shuki25/7-segment-display-controller/7-segment-display-controller.png

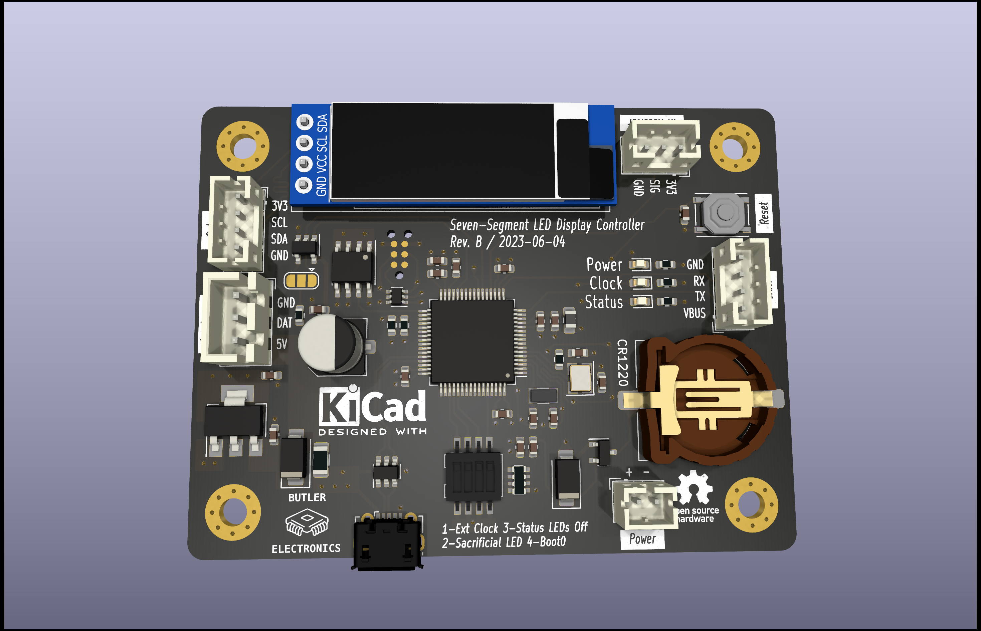
7-segment-display-controller.png
