shuki25/7-segment-display-controller/pdf/7-segment-display-controller__Assembly.pdf

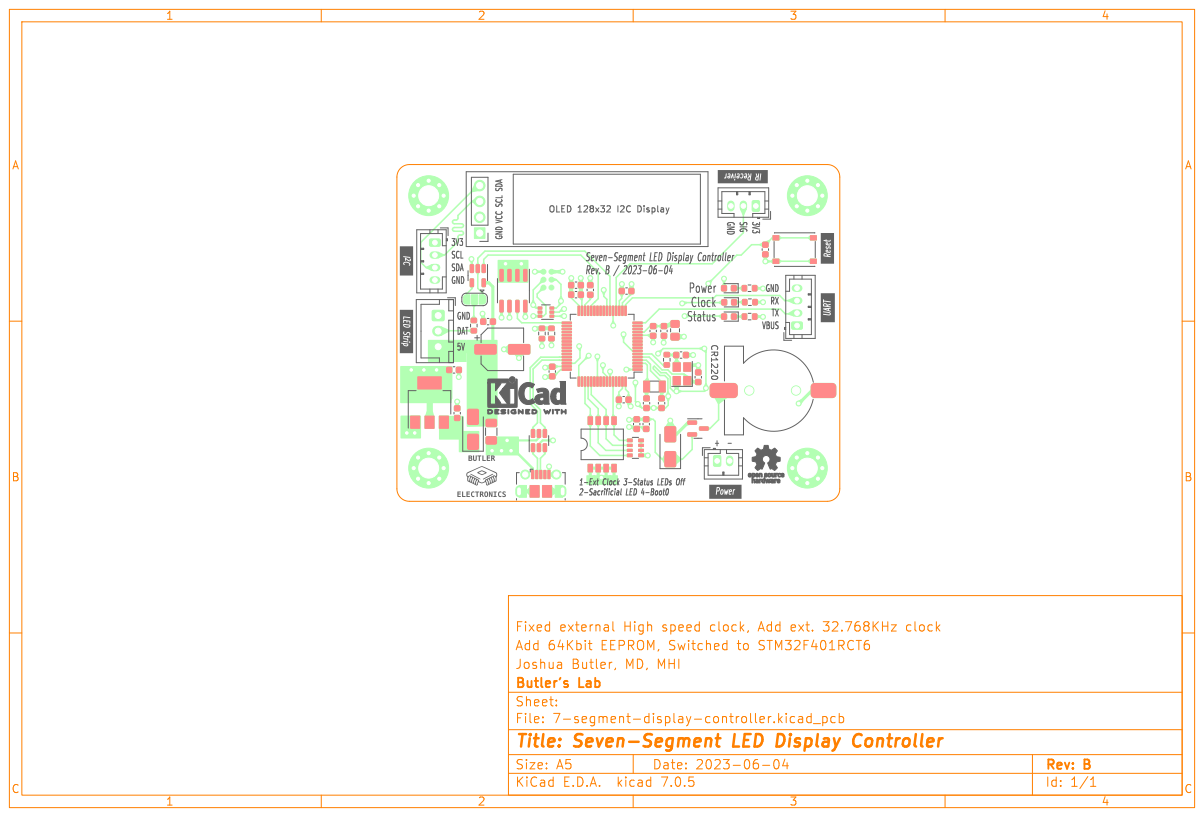
[picture p2: page 1]
SDA; Status; Seven-Segment LED Display Controller Rev. B / 2023-06-04; SIG 3V3; GND; GND CR1220; TX DAT GND; - 1-Ext Clock 3-Status LEDs Off 2-Sacrificial; LED 4-Boot0 SCL; Clock SDA GND; OLED 128x32 I2C Display SCL VCC 1; BC Date: 2023-06-04 KiCad; kicad; 7.0.5 Size: A5; Rev:; Id: 1/1 Title: Seven-Segment; LED Display Controller File: 7-segment-display-controller.kicad_pcb Sheet: Butler's; Lab; Joshua Butler,; MHI Add; 64Kbit EEPROM, Switched; to STM32F401RCT6 Fixed; external; High speed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

VBUS Power GND

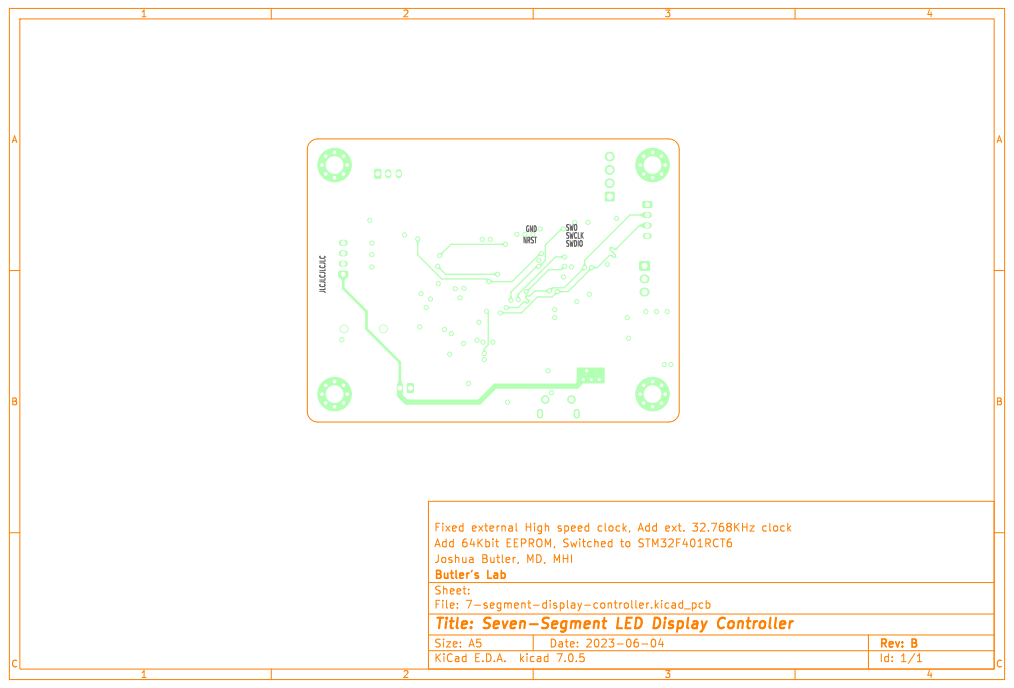
[picture p3: page 2]
BC Date: 2023-06-04 KiCad; kicad; 7.0.5 Size: A5; Rev:; Id: 1/1 Title: Seven-Segment; LED Display Controller File: 7-segment-display-controller.kicad_pcb Sheet: Butler's; Lab; Joshua Butler,; MHI Add; 64Kbit EEPROM, Switched; to STM32F401RCT6 Fixed; external; High speed; clock,; Add; ext. 32.768KHz; clock
