shuki25/7-segment-display-controller/pdf/7-segment-display-controller.pdf

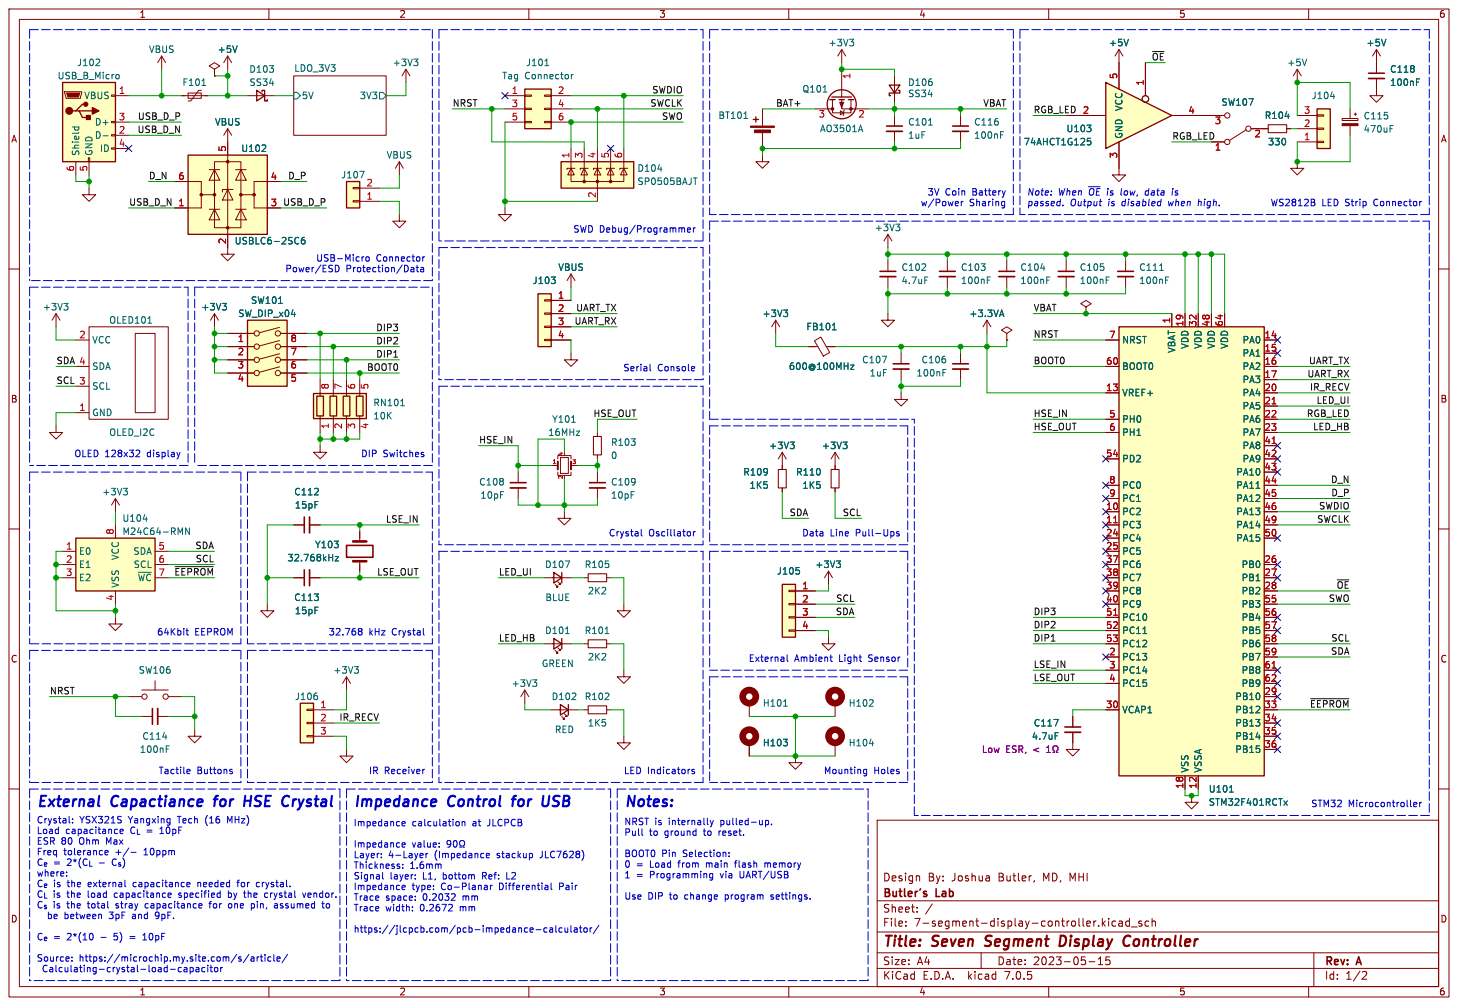
[picture p4: page 1]

1 PC2 10 PC3 11 VSSA 12 VREF+ 13 PA0 14 PA1 15 PA2 16 PA3 17 VSS 18 VDD 19 PC13 2 PA4 20 PA5 21 PA6 22 PA7 23 PC4 24 PC5 25 PB0 26 PB1 27 PB2 28 PB10 29 PC14 3 VCAP1 30 VDD 32 PB12 33 PB13 34 PB14 35 PB15 36 PC6 37 PC7 38 PC8 39 PC15 4 PC9 40 PA8 41 PA9 42 PA10 43 PA11 44 PA12 45 PA13 46 VDD 48 PA14 49 PH0 5 PA15 50 PC10 51 PC11 52 PC12 53 PD2 54 PB3 55 PB4 56 PB5 57 PB6 58 PB7 59 PH1 6 BOOT0 60 PB8 61 PB9 62 VDD 64 NRST 7 PC0 8 PC1 9 U101 STM32F401RCTx

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

4 SDA 5 SCL 6 ~{WC}7 VCC

Signal layer: L1, bottom Ref: L2

C_{e}= 2*(10 - 5) = 10pF Source: https://microchip.my.site.com/s/article/

https://jlcpcb.com/pcb-impedance-calculator/

Calculating-crystal-load-capacitor

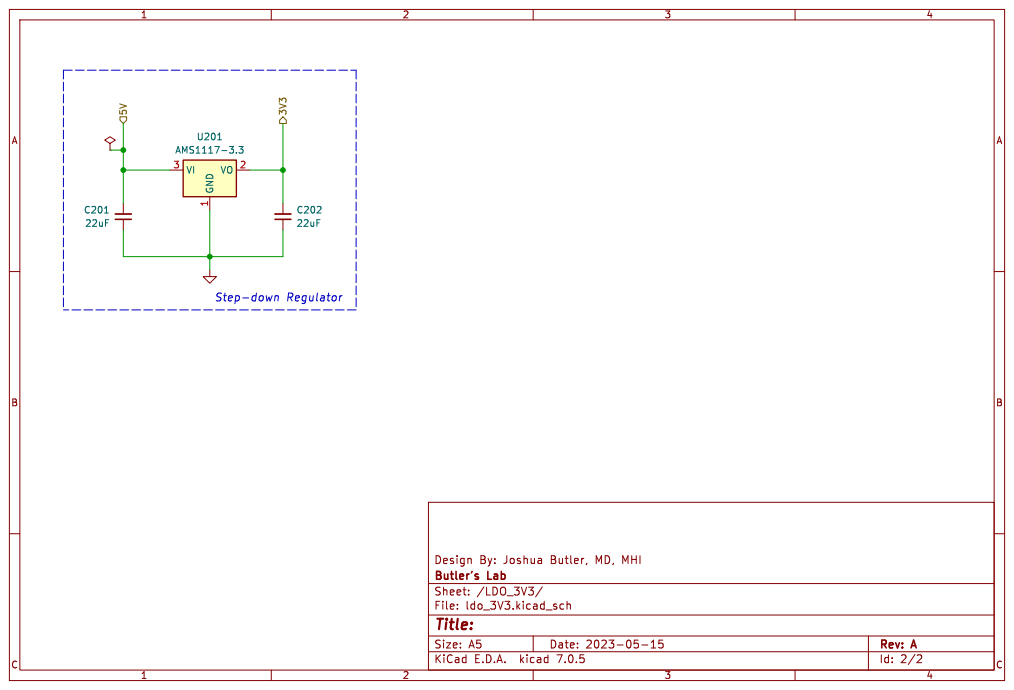
[picture p5: page 2]
