shuki25/7-segment-display-controller/7-segment-display-controller.kicad_pcb

## KiCad design 7-segment-display-controller.kicad_pcb (2023-06-27)

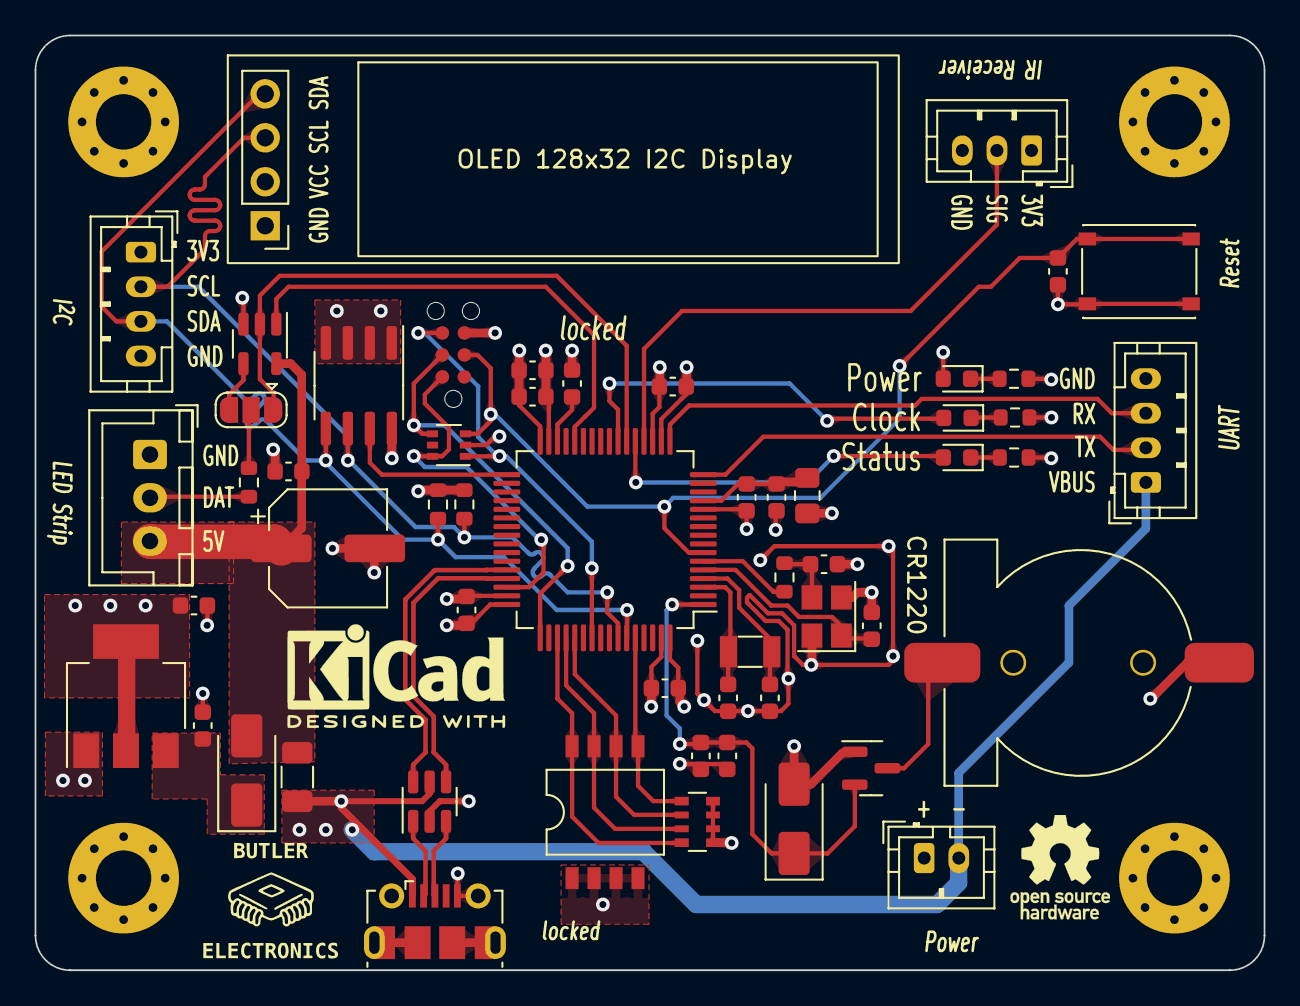
[picture p6: board 7-segment-display-controller.kicad_pcb from above]

Board: 4 copper layers, 71.0 x 54.0 mm, 59 parts (0 on the bottom side), 42 nets.

Parts:
BT101: Battery_Cell; BatteryHolder_CR1220
C101, C107: 1uF; C_0603_1608Metric
C102, C117: 4.7uF; C_0603_1608Metric
C103, C104, C105, C106, C111, C114, C116, C118: 100nF; C_0603_1608Metric
C108, C109: 10pF; C_0603_1608Metric
C112, C113: 15pF; C_0603_1608Metric
C115: 470uF; CP_Elec_6.3x7.7
C201, C202: 22uF; C_0603_1608Metric
D101: GREEN; LED_0603_1608Metric
D102: RED; LED_0603_1608Metric
D103, D106: SS34; D_SMA
D104: SP0505BAJT; SOT-363_SC-70-6
D107: BLUE; LED_0603_1608Metric
F101: Polyfuse_Small; Fuse_1206_3216Metric
FB101: 600@100MHz; L_0805_2012Metric_Pad1.15x1.40mm_HandSolder
H101, H102, H103, H104: MountingHole; MountingHole_3.2mm_M3_Pad_Via
J101: Tag Connector; TC2030-IDC-NL
J102: USB_B_Micro; USB_Micro-B_Molex-105017-0001
J103, J105: JST 2.54 Header; JST_PH_B4B-PH-K_1x04_P2.00mm_Vertical
J104: JST 2.54 Header; JST_XH_B3B-XH-A_1x03_P2.50mm_Vertical
J106: JST 2.54 Header; JST_PH_B3B-PH-K_1x03_P2.00mm_Vertical
J107: Conn_01x02; JST_PH_B2B-PH-K_1x02_P2.00mm_Vertical
OLED101: OLED_I2C; OLED_128x32_I2C_4pins
Q101: AO3501A; SOT-23
R101, R105: 2K2; R_0603_1608Metric
R102, R109, R110: 1K5; R_0603_1608Metric
R103: 0; R_0603_1608Metric
R104: 330; R_0603_1608Metric
RN101: 10K; R_Array_Convex_4x0603
SW101: SW_DIP_x04; SMDIP-8_W6.6mm
SW106: SW_Push; XKB-Connectivity-TS-1187A-B-A-B
SW107: SW_SPDT; SolderJumper-3_P1.3mm_Open_RoundedPad1.0x1.5mm
U101: STM32F401RCTx; LQFP-64_10x10mm_P0.5mm
U102: USBLC6-2SC6; SOT-23-6
U103: 74AHCT1G125; SOT-23-5
U104: M24C64-RMN; SOIC-8_3.9x4.9mm_P1.27mm
U201: AMS1117-3.3; SOT-223-3_TabPin2
Y101: 16MHz; Crystal_SMD_3225-4Pin_3.2x2.5mm
Y103: 32.768kHz; Crystal_SMD_3215-2Pin_3.2x1.5mm

Connections:
+3.3VA: C106.1, C107.1, FB101.1, U101.13 (VREF+)
+3V3: C102.1, C103.1, C104.1, C105.1, C111.1, C202.2, D102.2 (A), D106.2 (A), FB101.2, J105.1, J106.1, OLED101.2 (VCC), Q101.1 (G), R109.2, R110.2, SW101.1, SW101.2, SW101.3, SW101.4, U101.19 (VDD), U101.32 (VDD), U101.48 (VDD), U101.64 (VDD), U104.8 (VCC), U201.2 (VO)
+5V: C115.1, C118.1, D103.2 (A), F101.2, J104.3, U103.5 (VCC)
/BAT+: BT101.1 (+), Q101.3 (D)
/BOOT0: RN101.5 (R4.2), SW101.5, U101.60 (BOOT0)
/DIP1: RN101.6 (R3.2), SW101.6, U101.53 (PC12)
/DIP2: RN101.7 (R2.2), SW101.7, U101.52 (PC11)
/DIP3: RN101.8 (R1.2), SW101.8, U101.51 (PC10)
/D_N: U101.44 (PA11), U102.6 (I/O1)
/D_P: U101.45 (PA12), U102.4 (I/O2)
/HSE_IN: C108.1, U101.5 (PH0), Y101.1
/HSE_OUT: R103.1, U101.6 (PH1)
/IR_RECV: J106.2, U101.20 (PA4)
/LDO_3V3/5V: C201.2, D103.1 (K), U201.3 (VI)
/LED_HB: D101.2 (A), U101.23 (PA7)
/LED_UI: D107.2 (A), U101.21 (PA5)
/LSE_IN: C112.2, U101.3 (PC14), Y103.2
/LSE_OUT: C113.2, U101.4 (PC15), Y103.1
/NRST: C114.1, D104.3 (K), J101.3, SW106.1, U101.7 (NRST)
/RGB_LED: SW107.1 (A), U101.22 (PA6), U103.2
/SCL: J105.2, OLED101.3 (SCL), R110.1, U101.58 (PB6), U104.6 (SCL)
/SDA: J105.3, OLED101.4 (SDA), R109.1, U101.59 (PB7), U104.5 (SDA)
/SWCLK: D104.4 (K), J101.4, U101.49 (PA14)
/SWDIO: D104.6 (K), J101.2, U101.46 (PA13)
/SWO: D104.1 (K), J101.6, U101.55 (PB3)
/UART_RX: J103.3, U101.17 (PA3)
/UART_TX: J103.2, U101.16 (PA2)
/USB_D_N: J102.2 (D-), U102.1 (I/O1)
/USB_D_P: J102.3 (D+), U102.3 (I/O2)
/VBAT: C101.1, C116.1, D106.1 (K), Q101.2 (S), U101.1 (VBAT)
/~EEPROM: U101.33 (PB12), U104.7 (~WC)
/~OE: U101.28 (PB2), U103.1
GND: BT101.2 (-), C101.2, C102.2, C103.2, C104.2, C105.2, C106.2, C107.2, C108.2, C109.2, C111.2, C112.1, C113.1, C114.2, C115.2, C116.2, C117.2, C118.2, C201.1, C202.1, D104.2 (A), H101.1, H102.1, H103.1, H104.1, J101.5, J102.5 (GND), J102.6 (Shield), J103.4, J104.1, J105.4, J106.3, J107.1, OLED101.1 (GND), R101.2, R102.2, R105.2, RN101.1 (R1.1), RN101.2 (R2.1), RN101.3 (R3.1), RN101.4 (R4.1), SW106.2, U101.12 (VSSA), U101.18 (VSS), U101.31 (VSS), U101.47 (VSS), U101.63 (VSS), U102.2 (GND), U103.3 (GND), U104.1 (E0), U104.2 (E1), U104.3 (E2), U104.4 (VSS), U201.1 (GND), Y101.2, Y101.4
unnamed: C109.1, R103.2, Y101.3
unnamed: D101.1 (K), R101.1
unnamed: D102.1 (K), R102.1
unnamed: D107.1 (K), R105.1
unnamed: J104.2, R104.1
unnamed: R104.2, SW107.2 (B)
unnamed: SW107.3 (C), U103.4
unnamed: C117.1, U101.30 (VCAP1)
VBUS: F101.1, J102.1 (VBUS), J103.1, J107.2, U102.5 (VBUS)
