shuki25/7-segment-display-controller/(commit log)

2023-05-16 update production files
    [7-segment-display-controller-CuBottom.gbr, 7-segment-display-controller-CuIn1.gbr, 7-segment-display-controller-CuIn2.gbr, 7-segment-display-controller-CuTop.gbr, 7-segment-display-controller-EdgeCuts.gbr, 7-segment-display-controller-MaskBottom.gbr, 7-segment-display-controller-MaskTop.gbr, 7-segment-display-controller-NPTH.drl]
2023-05-26 add alternate power source connector
    [7-segment-display-controller.kicad_pcb, 7-segment-display-controller.kicad_sch, ldo_3V3.kicad_sch]
2023-06-01 add 32.768KHz crystal
    [7-segment-display-controller.kicad_pcb, 7-segment-display-controller.kicad_sch]
2023-06-01 update uuid
    [ldo_3V3.kicad_sch]
2023-06-02 fix crystal pin assignments
    [7-segment-display-controller.kicad_pcb, 7-segment-display-controller.kicad_sch]
2023-06-06 switch MCU to STM32F401
    - switch MCU to STM32F401 because STM32F303 does not have DMA stream
    - add EEPROM
    - removed D+ pull-up resistor
    - switch status LED to blue, changed resistor values
    [7-segment-display-controller.kicad_pcb, 7-segment-display-controller.kicad_sch]
2023-06-06 update BOM
    [7-segment-display-controller-CuBottom.gbr, 7-segment-display-controller-CuIn1.gbr, 7-segment-display-controller-CuIn2.gbr, 7-segment-display-controller-CuTop.gbr, 7-segment-display-controller-EdgeCuts.gbr, 7-segment-display-controller-MaskBottom.gbr, 7-segment-display-controller-MaskTop.gbr, 7-segment-display-controller-NPTH.drl]
2023-06-27 update net color and schematic notes
    [7-segment-display-controller.kicad_pcb, 7-segment-display-controller.kicad_sch]
2023-11-20 update schematic pdf
